makerspace-wi/Garage-Control/README.md

# Garage Door Entry Control for Makerspace Wiesbaden
<br>

<br>

# Zusammenfassung:

- Kommunikation mit dem SYMCON Rechner via XBee ZBee Funktechnik
- Aussen RFID-Leser mit NOT STOP-Taste und Display (I2C Bus für RFID-Reader & Display, Tasterkontakte und LED) 
- Innen Arduino, Netzteil, XBee ZBee Modul und Relaisplatine (für Rolltorsteuerung)
- Das Steuerprogramm (Arduino) wird 'dumm' gehalten 
  - es sendet die gelesene UID und Tasterkontakte an Symcon zur Prüfung ob vorhanden und freigegeben
  - es reagiert auf Befehle von Symcon (z.B. 'OPEN' - 'CLOSE')
- es werden Rolltor Positionssensoren (Reed Kontakte) verwendet

# Nutzung
## ACHTUNG, lässt sich nur öffnen und schließen, wenn das Mitglied 'eingeloggt' ist
### Ausgangszustand Rolltor geschlossen

- Das Display vom Lesegerät ist deaktiviert
- RFID Chip an Lesegerät halten, das Display sollte einschalten und Nachrichten zeigen
- Wenn der Chip freigeschaltet ist, sendet Symcon einen 'OPEN' Befehl - das Tor öffnet sich
- ist der Chip nicht freigeschaltet oder das Mitglied nicht eingeloggt, verwirft Symcon die Öffnungsanfrage
- wenn das Rolltor die obere Position erreicht hat, wird dies im Display angezeigt und nach 15 Sekunden deaktiviert

### Ausgangszustand Rolltor geöffnet

- Das Display vom Lesegerät ist deaktiviert
- RFID Chip an Lesegerät halten, das Display sollte einschalten und Nachrichten zeigen
- Wenn der Chip freigeschaltet ist, sendet Symcon einen 'CLOSE' Befehl - das Tor schliesst sich
- ist der Chip nicht freigeschaltet oder das Mitglied nicht eingeloggt, verwirft Symcon die Schließanfrage
- wenn das Rolltor die untere Position erreicht hat, wird dies im Display angezeigt und nach 15 Sekunden deaktiviert

### NOT STOP Funktion

- Mit der Taste <b>(NOT-STOP)</b> am Lesegerät kann das Auf- oder Zufahren sofort gestoppt werden, falls sich versehentlich etwas im Führungsweg des Rolltors befindet
- bei Betätigung der Taste bleibt das Rolltor sofort stehen und fährt erst nach nochmaligem präsentieren des RFID-Chips erst mal in die <b>"Offen"-Position</b> 
- die Richtung des Rolltors kann durch Betätigung der Taste während des Laufs geändert werden: <b>ACHTUNG Weg frei?</b>
  - Dafür muss die Taste für 30sec <b>dauerhaft</b> gedrückt werden 
  - Nach ca. 2sec wird das Öffnen bendet und im Display wir der <b>Panic-Mode</b> angezeigt.
  - Nach Ablauf der Zeit fährt das Rolltor nach unten, dies kann wieder mit der Taste abgebrochen werden.

### Was wird geloggt?
- jede Öffnung und folgende Schließung wird in der Datenbank geloggt
- es wird
  - die Öffnungs Datum/Zeit, die Mitglieds MID und der Name des Mitglieds
  - die Schließungs Datum/Zeit, die Mitglieds MID und der Name des Mitglieds
  - und wie lange die Garage geöffnet war aufgezeichnet
- die Daten werden nach 30 Tage gelöscht

### Wenn es Probleme gibt
#### Der RFID-Chip wird nicht erkannt
bitte mehrfach versuchen - bleibt dies erfolglos ist der kleine rote RESET-Button an der Unterseite des Lesegerätes zu betätigen. Danach bitte warten, bis sich das Gerät mit unserem System neu synchronisiert hat und den aktuellen Timestamp anzeigt. Danach sollte der RFID-Chip wieder erkannt werden.<br>

#### Die elektronische Öffnungs-/Schließelektronik funktioniert nicht
bitte an einen Werkstattleiter wenden - unser Backup-Schlüssel wird im Werkstattleiterfach aufbewahrt
#### Die Garage Door Entry Control ist auch unsere Alarmanlage
Wird das Garagentor gewaltsam oder per Schlüssel geöffnet - geht sofort ein <b>Intrusion Alarm</b> an die Administratoren und den Vorstand
<br><br>


<br>

<br>
