makerspace-wi/Garage-Control/doc/GarageOpt_RFID_IP40.pdf

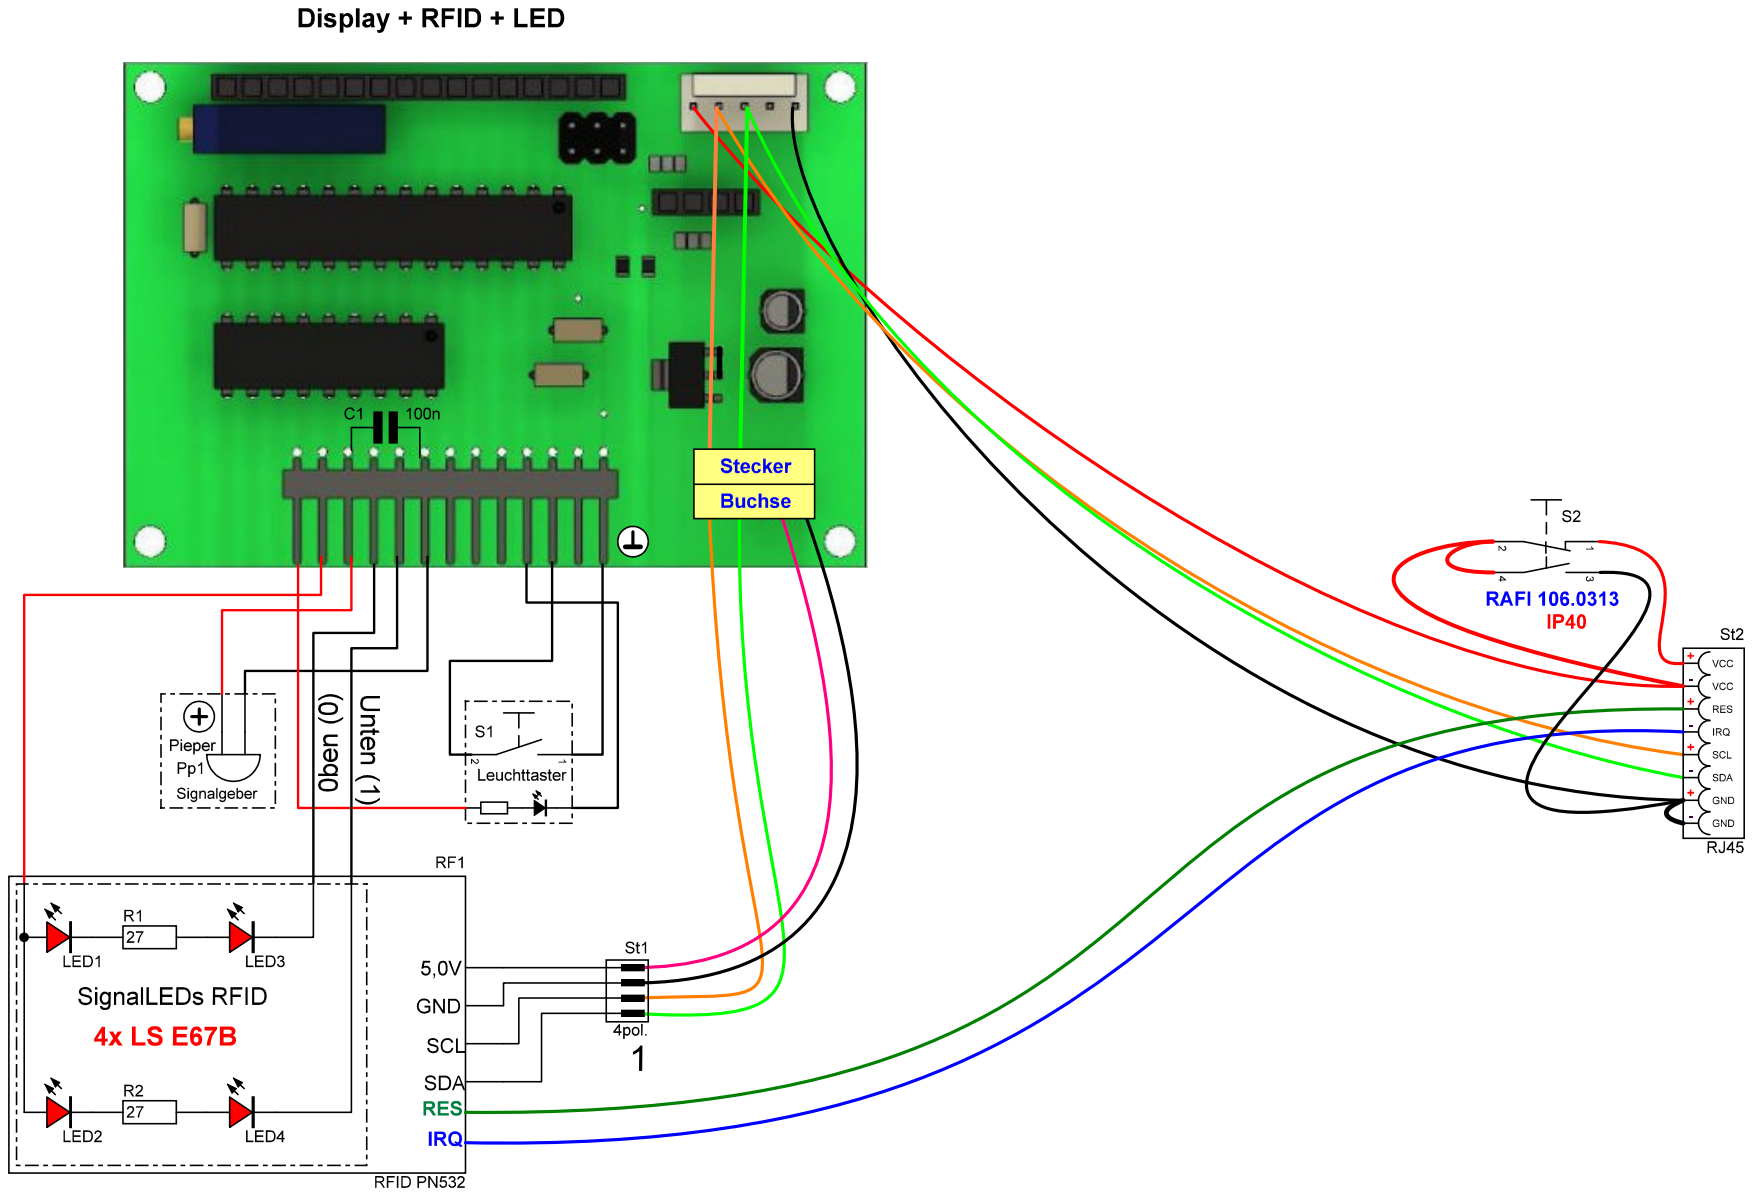
[picture p1: page 1]

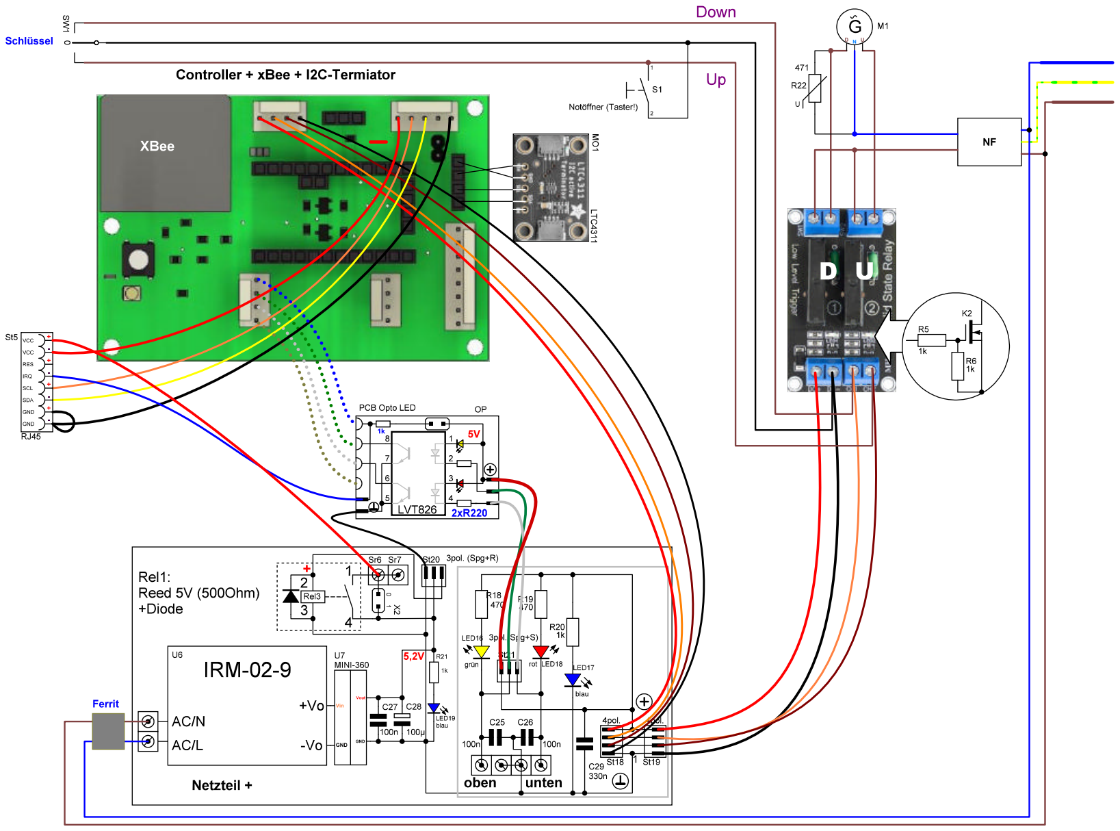
[picture p2: page 2]

0

[N]

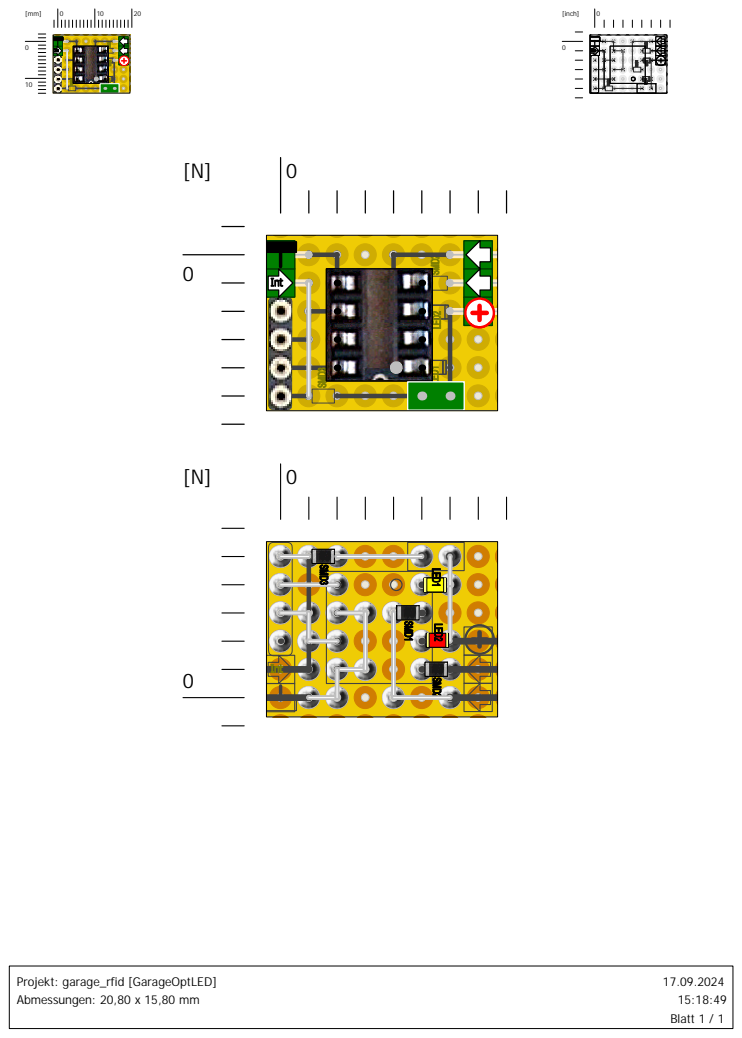
[picture p3: page 3]
[inch]; Projekt: garage_rfid [GarageOptLED] Abmessungen: 20,80 x 15,80 mm; 17.09.2024 15:18:49 Blatt 1 / 1

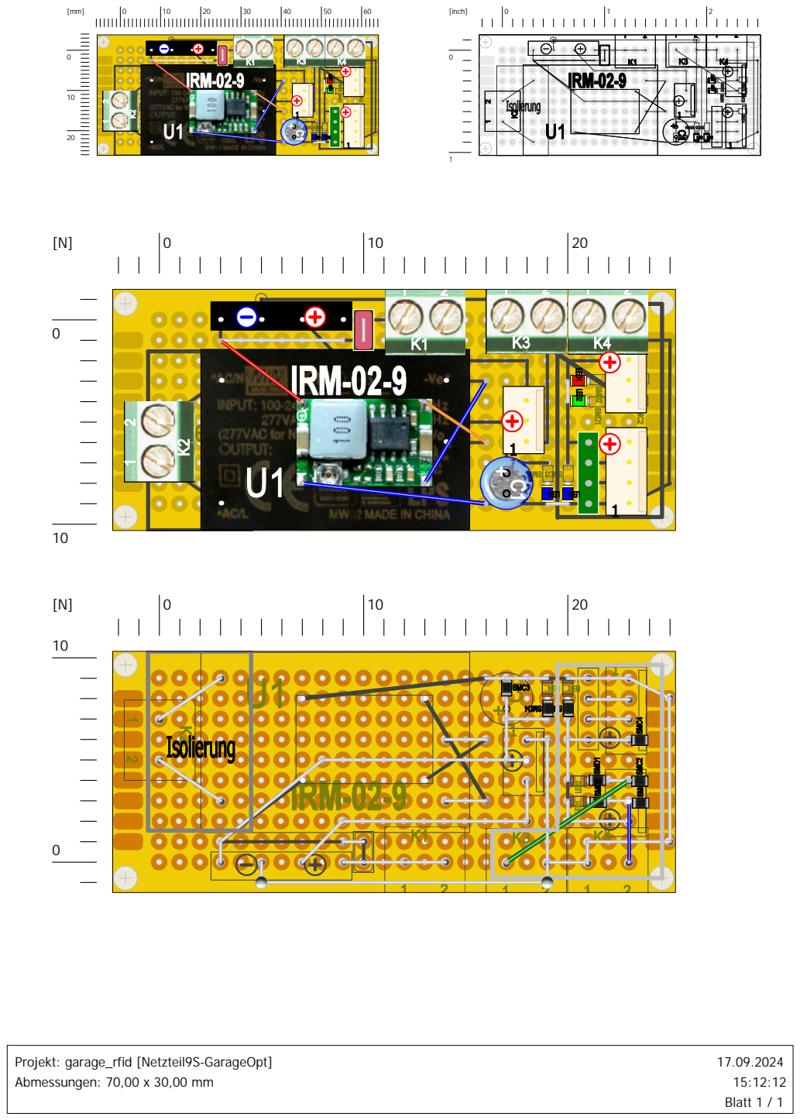
[picture p4: page 4]
[inch]; Projekt: garage_rfid [Netzteil9S-GarageOpt] Abmessungen: 70,00 x 30,00 mm; 17.09.2024 15:12:12 Blatt 1 / 1
