makerspace-wi/Garage-Control/(commit log)

2021-09-30 Update RFID_Access.ino
    OPEN/CLOSE Status korrigiert
    [RFID_Access.ino]
2021-09-30 Update RFID_Access.ino
    added 'rstatus' - request sensor status - i.e. 3 = moving, 1 = open, 2 = closed, 0 = hardware error
    [RFID_Access.ino]
2022-10-28 Update RFID_Access.ino
    relay corrected
    [RFID_Access.ino]
2022-10-28 update switching
2022-10-29 update code and schematic diagram
2022-11-01 changed interupt pin
2022-11-01 update irq and reset
    [RFID_Access.ino]
2022-11-03 changed pins and RFID to IRQ on I2C
2022-11-03 Change document RFID 5V now
2023-08-20 Change fast reset relais and add reset command
    [RFID_Access.ino]
2023-08-22 Send door status if timer is 0 after moving
2023-08-23 Add connector and capacitor in documents
2023-08-24 Show message on display if wrong xbee name
    [RFID_Access.ino]
2023-09-19 Add reset for rfid and rename reset and request
    [RFID_Access.ino]
2024-01-30 Changed reset button
2024-02-08 Include push button to open the door
2024-06-05 change switch request
2024-08-14 Replace powersupply with new version
2024-08-14 changed name and power supply
2024-08-15 update document (replace wrong pcb)
